ohammer-ai/novadac/20260326_000515.jpg

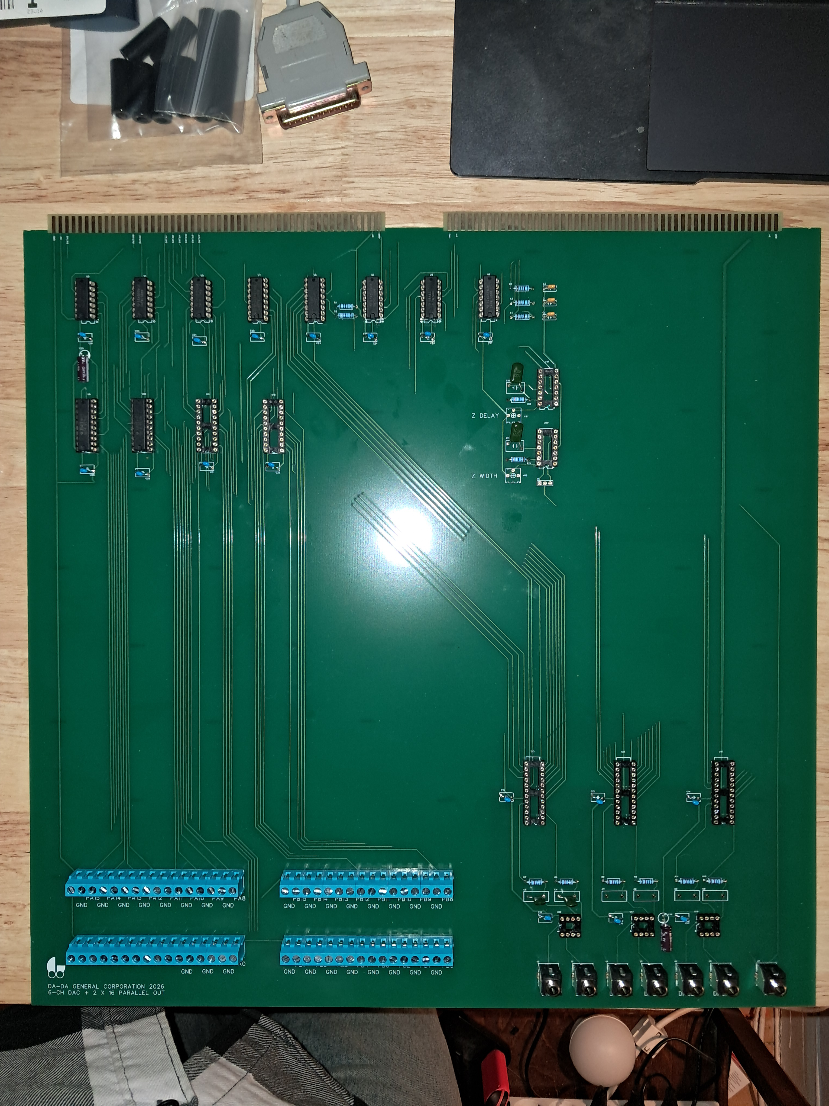
20260326_000515.jpg
