ohammer-ai/novadac/SCH_6-channel DAC for Data General_2026-03-29.pdf

# 5Y 10 5A 11 6Y 12 6A 13 VCC 14

# 5Y 10 5A 11 6Y 12 6A 13 VCC 14

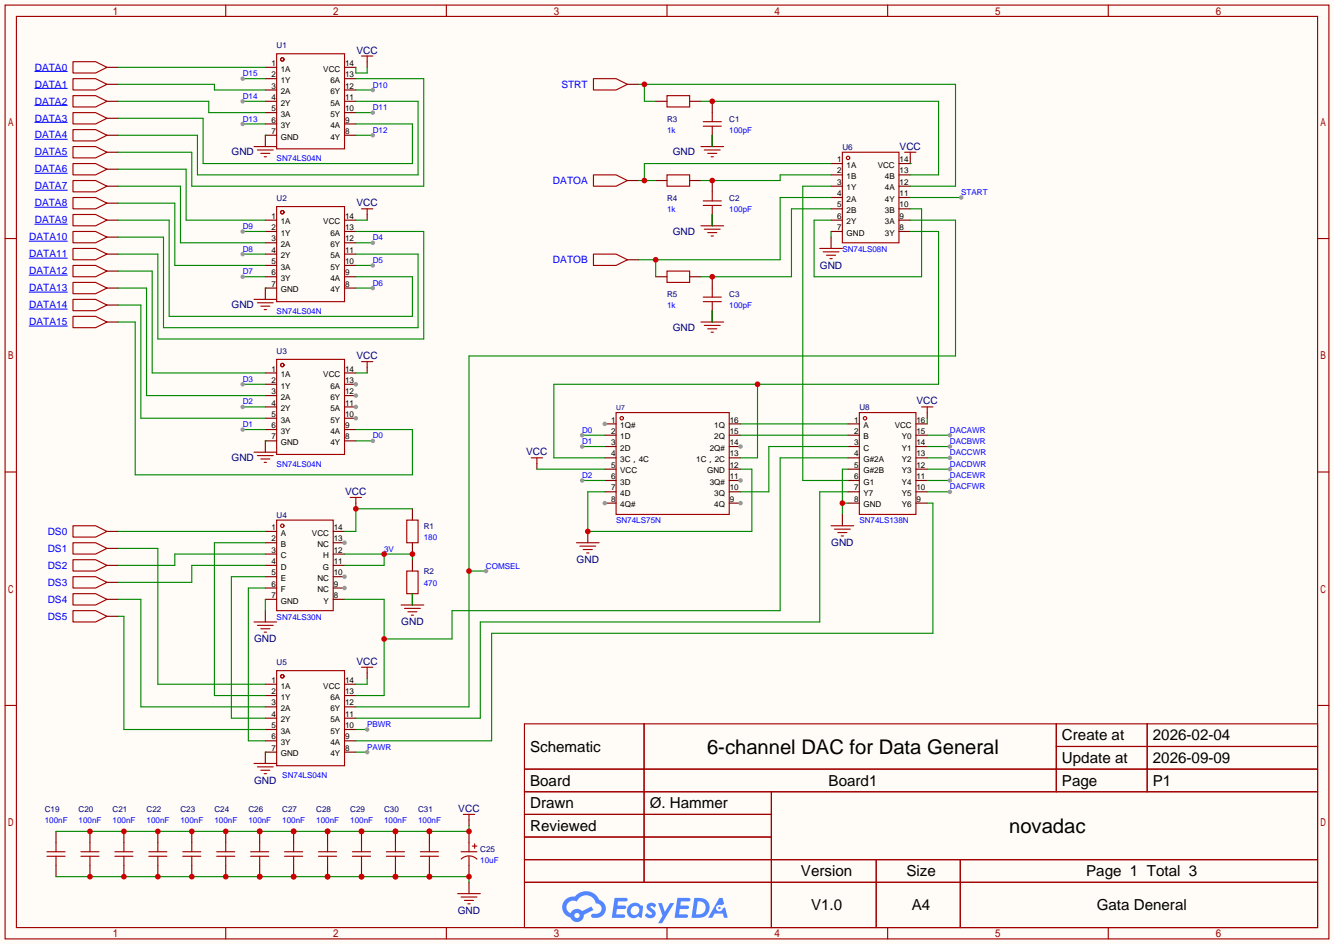
[picture p2: page 1]

Schematic | 6-channel DAC for Data General | Create at | 2026-02-04

Update at | 2026-09-09

Board | Board1 | Page | P1
Drawn | Ø. Hammer | novadac
Reviewed

Version | Size | Page 1 Total 3
V1.0 | A4 | Gata Deneral

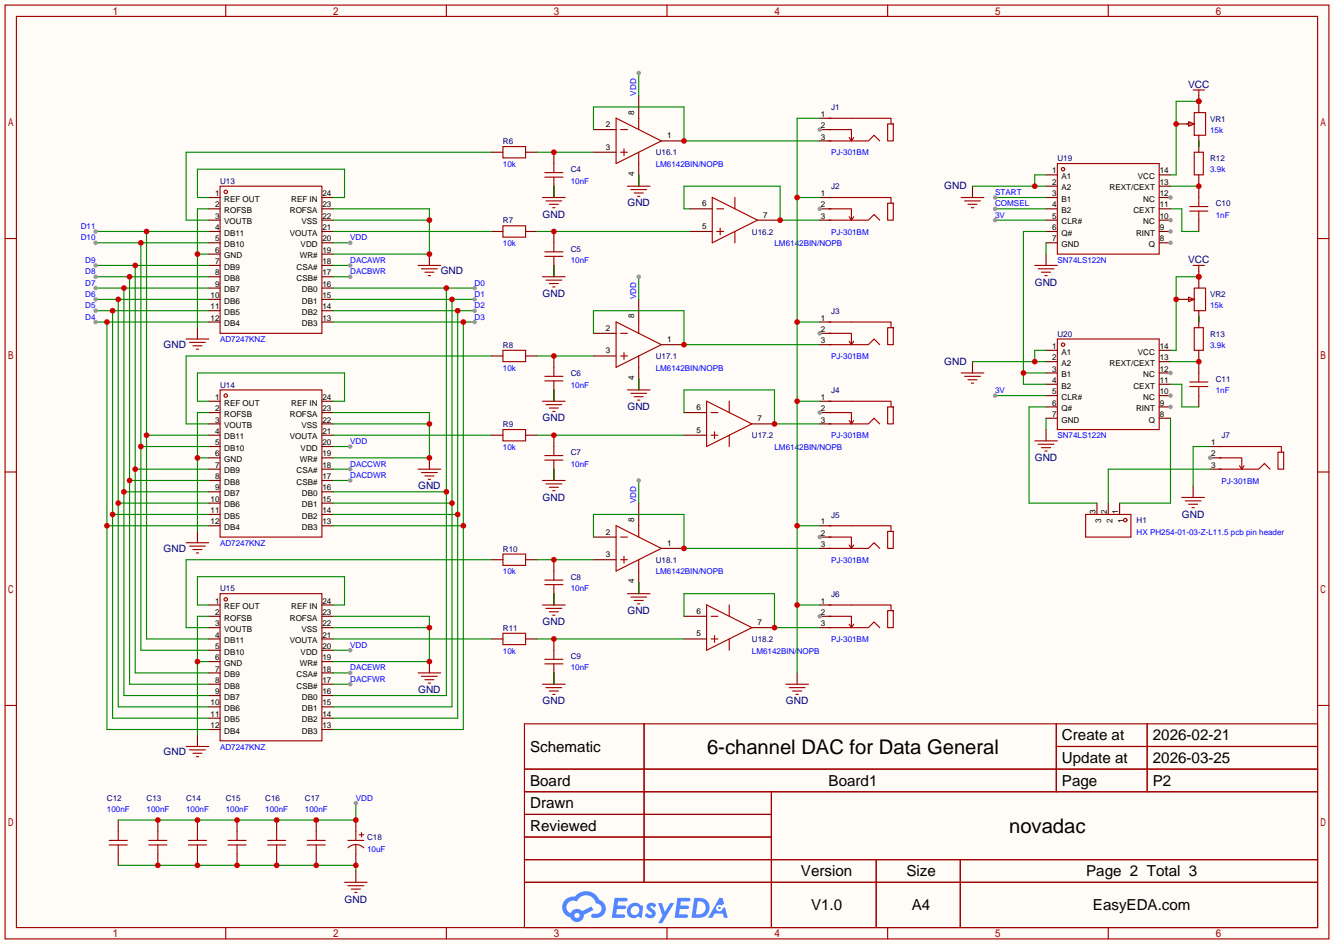
[picture p3: page 2]

Schematic | 6-channel DAC for Data General | Create at | 2026-02-21

Update at | 2026-03-25

Board | Board1 | Page | P2
Drawn | | novadac
Reviewed

Version | Size | Page 2 Total 3
V1.0 | A4 | EasyEDA.com

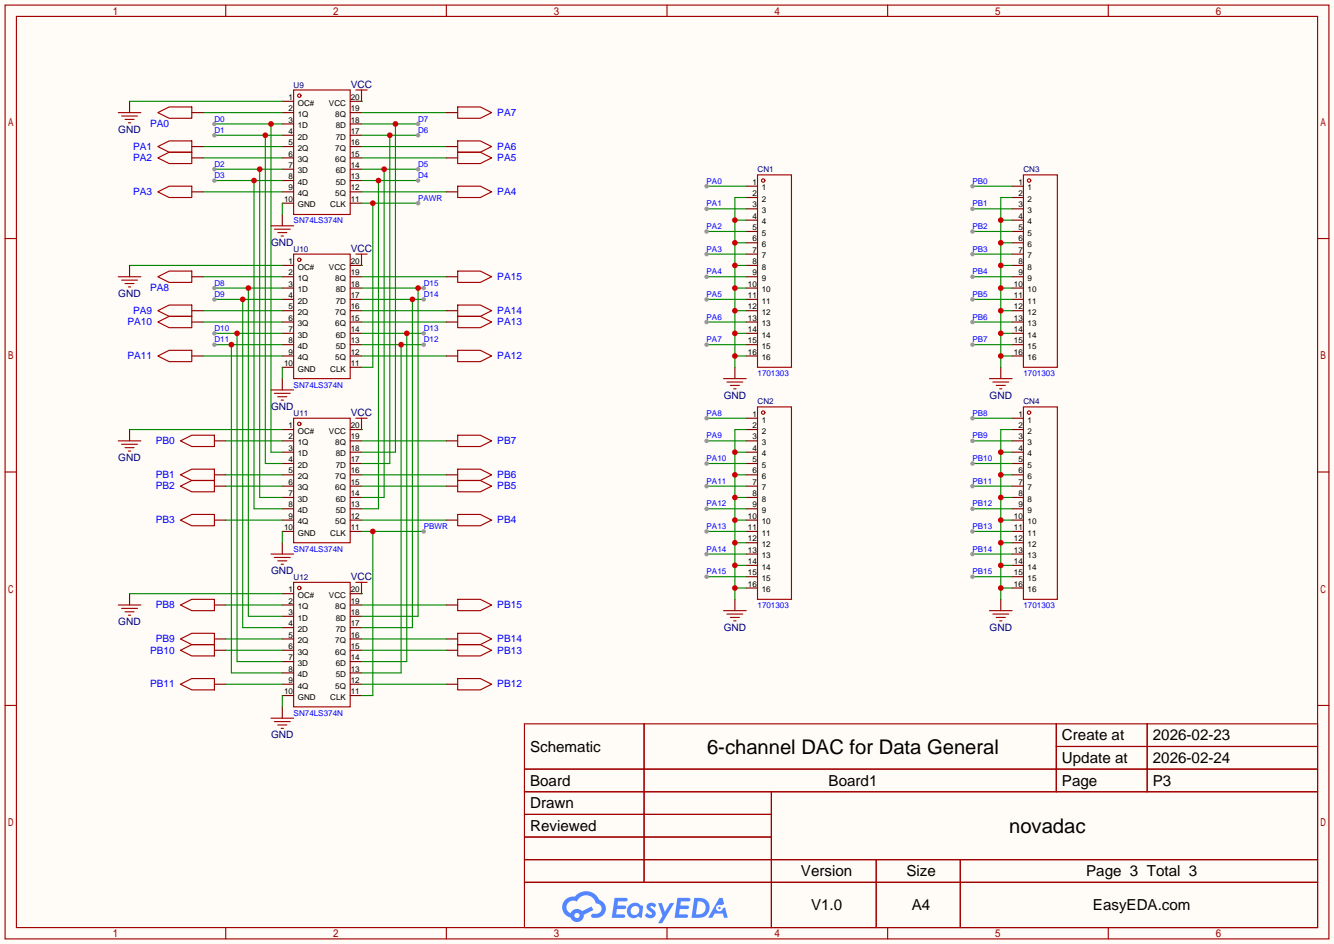
[picture p4: page 3]

Schematic | 6-channel DAC for Data General | Create at | 2026-02-23

Update at | 2026-02-24

Board | Board1 | Page | P3
Drawn | | novadac
Reviewed

Version | Size | Page 3 Total 3
V1.0 | A4 | EasyEDA.com
