ohammer-ai/novadac/(list of files, drawings)

Other design files:
novadac.eprj
